Joe-Purvis/Power/Power.kicad_pcb

## KiCad design Power.kicad_pcb (2026-10-29)

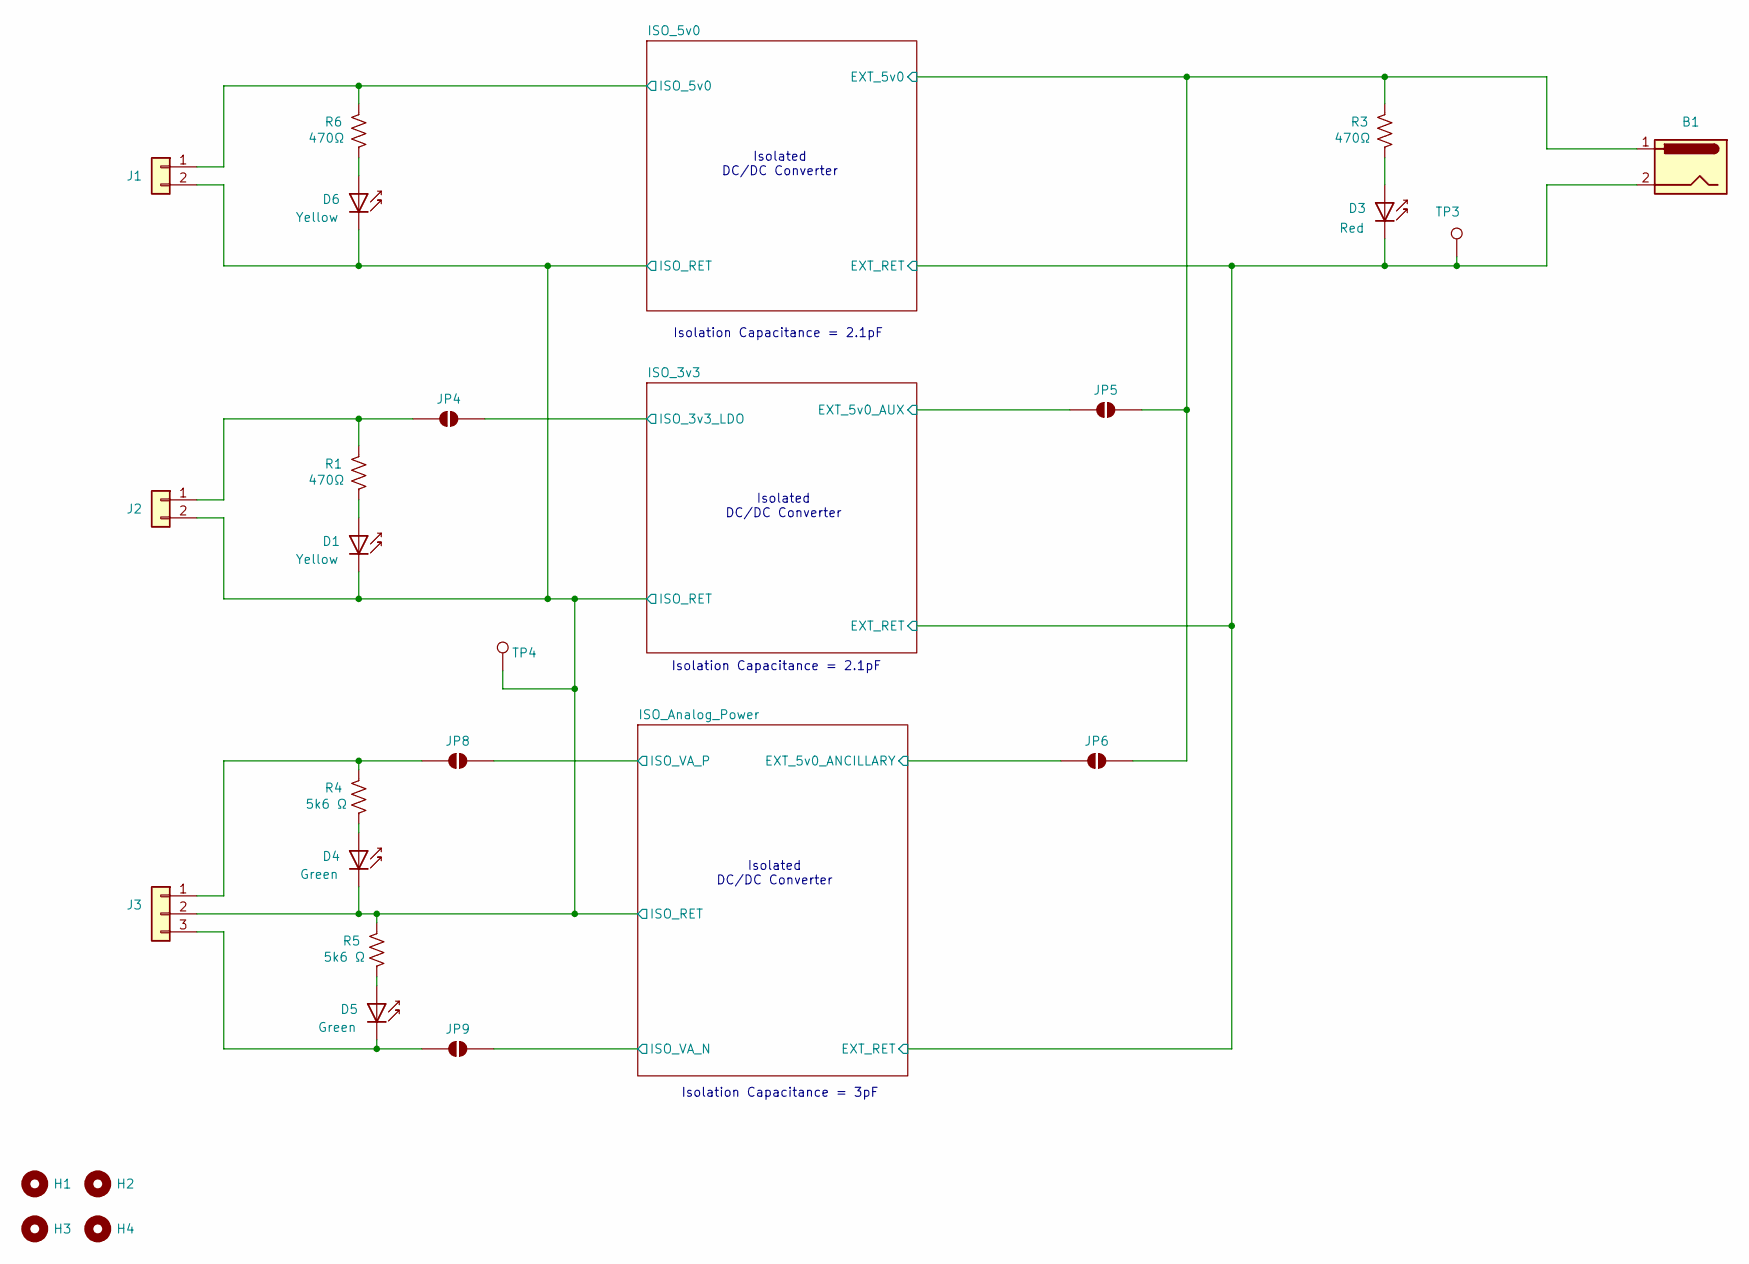
[picture p1: schematic Power.kicad_sch]

Parts:
B1: Barrel_Jack; BarrelJack_CUI_PJ-063AH_Horizontal
D1, D6: Yellow; LED_1206_3216Metric; LCSC C2298
D3: Red; LED_1206_3216Metric; LCSC C49018
D4, D5: Green; LED_1206_3216Metric; LCSC C14641
H1, H2, H3, H4: MountingHole; MountingHole_2.2mm_M2
J1, J2: Conn_01x02; PinHeader_1x02_P2.54mm_Vertical
J3: Conn_01x03; PinHeader_1x03_P2.54mm_Vertical
JP4, JP5, JP6, JP8, JP9: SolderJumper_2_Open; SolderJumper-2_P1.3mm_Open_RoundedPad1.0x1.5mm
R1, R3, R6: 470Ω; R_1206_3216Metric_Pad1.30x1.75mm_HandSolder; LCSC C4502
R4, R5: 5k6 Ω; R_1206_3216Metric_Pad1.30x1.75mm_HandSolder; Tolerance 5%; LCSC C2889795
TP3, TP4: TestPoint; TestPoint_Keystone_5000-5004_Miniature

Connections:
/ISO_3v3/EXT_5v0_AUX: JP5.1 (A); also elsewhere on the board
/ISO_3v3/EXT_RET: B1.2, D3.1 (K), TP3.1 (1_1); also elsewhere on the board
/ISO_3v3/ISO_3v3_LDO: JP4.2 (B); also elsewhere on the board
/ISO_5v0/EXT_5v0: B1.1, JP5.2 (B), JP6.2 (B), R3.2; also elsewhere on the board
/ISO_5v0/ISO_5v0: J1.1, R6.2; also elsewhere on the board
/ISO_Analog_Power/EXT_5v0_ANCILLARY: JP6.1 (A); also elsewhere on the board
/ISO_Analog_Power/ISO_RET: D1.1 (K), D4.1 (K), D6.1 (K), J1.2, J2.2, J3.2, R5.2, TP4.1 (1_1); also elsewhere on the board
/ISO_Analog_Power/ISO_VA_N: JP9.2 (B); also elsewhere on the board
/ISO_Analog_Power/ISO_VA_P: JP8.2 (B); also elsewhere on the board
unnamed: D1.2 (A), R1.1
unnamed: D3.2 (A), R3.1
unnamed: D4.2 (A), R4.1
unnamed: D5.2 (A), R5.1
unnamed: D5.1 (K), J3.3, JP9.1 (A)
unnamed: D6.2 (A), R6.1
unnamed: J2.1, JP4.1 (A), R1.2
unnamed: J3.1, JP8.1 (A), R4.2

Notes on the sheet:
Isolated DC/DC Converter
Isolation Capacitance = 2.1pF
Isolation Capacitance = 3pF

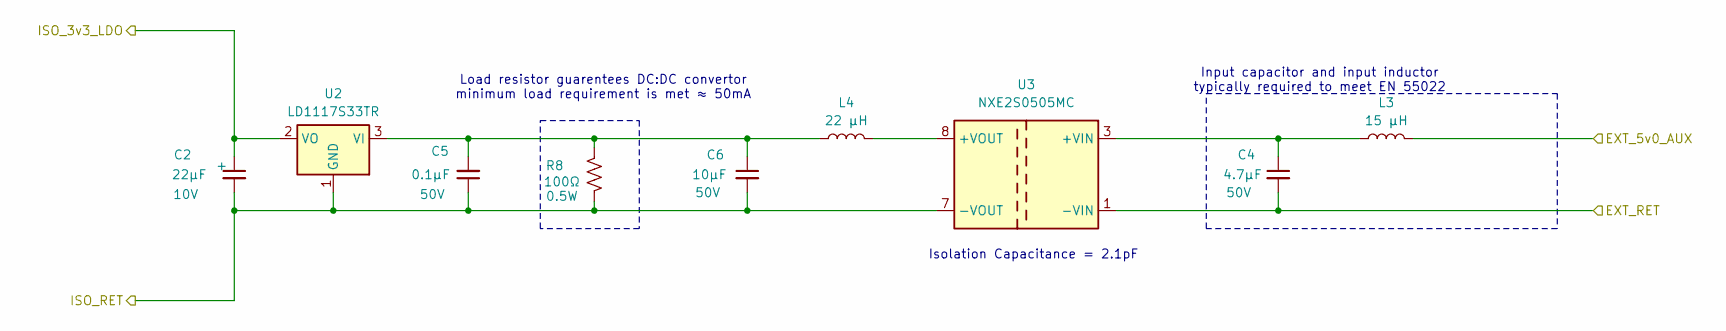
[picture p2: schematic ISO_3v3.kicad_sch]

Parts:
C2: 22µF; CP_EIA-3216-18_Kemet-A; Voltage Rating 10V; Tolerance 10%; LCSC C503893
C4: 4.7µF; C_1206_3216Metric; Voltage Rating 50V; LCSC C29823
C5: 0.1µF; C_1206_3216Metric_Pad1.33x1.80mm_HandSolder; Voltage Rating 50V; LCSC C24497
C6: 10µF; C_1206_3216Metric_Pad1.33x1.80mm_HandSolder; Voltage Rating 50V; LCSC C13585
L3: 15 µH; L_Changjiang_FNR4018S; Current Rating 1A; LCSC C167809
L4: 22 µH; L_Sunlord_SWPA5040; Current Rating 1.5A; LCSC C68434
R8: 100Ω; R_1206_3216Metric_Pad1.30x1.75mm_HandSolder; Voltage Rating 7.07V power-limited at 0.5W; series lim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; Tolerance 1%; LCSC C2978216
U2: LD1117S33TR; SOT-223-3_TabPin2; LCSC C86781
U3: NXE2S0505MC; Converter_DCDC_Murata_NXExSxxxxMC_SMD; LCSC C5817088

Connections:
/ISO_3v3/EXT_5v0_AUX: L3.2; also elsewhere on the board
/ISO_3v3/EXT_RET: C4.2, U3.1 (-VIN); also elsewhere on the board
/ISO_3v3/ISO_3v3_LDO: C2.1, U2.2 (VO); also elsewhere on the board
/ISO_Analog_Power/ISO_RET: C2.2, C5.1, C6.2, R8.1, U2.1 (GND), U3.7 (-VOUT); also elsewhere on the board
unnamed: C5.2, C6.1, L4.1, R8.2, U2.3 (VI)
unnamed: C4.1, L3.1, U3.3 (+VIN)
unnamed: L4.2, U3.8 (+VOUT)

Notes on the sheet:
Load resistor guarentees DC:DC convertor minimum load requirement is met ≈ 50mA
Input capacitor and input inductor typically required to meet EN 55022
Isolation Capacitance = 2.1pF

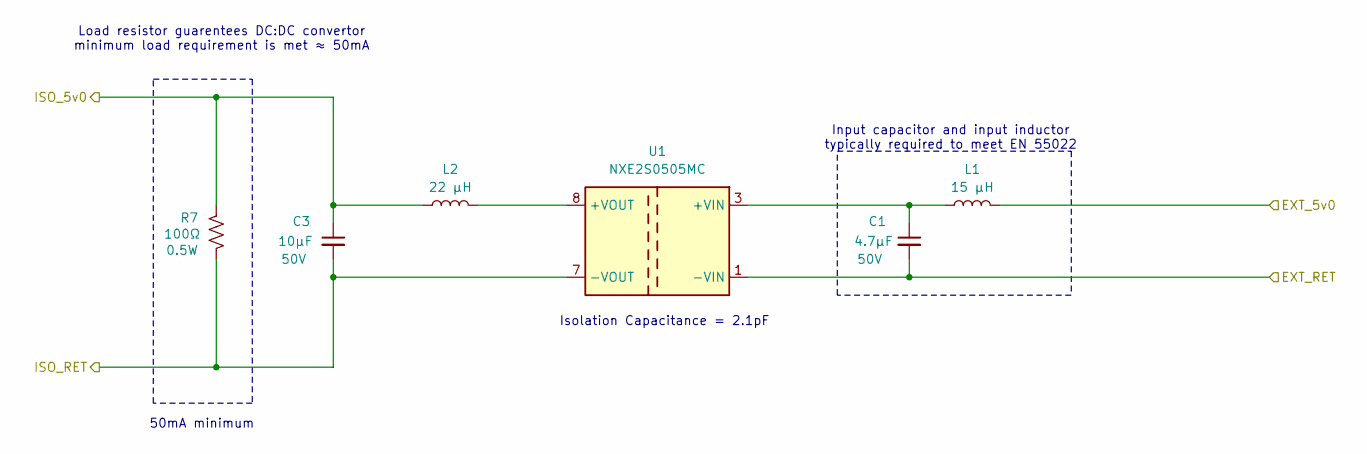
[picture p3: schematic ISO_5v0.kicad_sch]

Parts:
C1: 4.7µF; C_1206_3216Metric; Voltage Rating 50V; LCSC C29823
C3: 10µF; C_1206_3216Metric_Pad1.33x1.80mm_HandSolder; Voltage Rating 50V; LCSC C13585
L1: 15 µH; L_Changjiang_FNR4018S; Current Rating 1A; LCSC C167809
L2: 22 µH; L_Sunlord_SWPA5040; Current Rating 1.5A; LCSC C68434
R7: 100Ω; R_1206_3216Metric_Pad1.30x1.75mm_HandSolder; Voltage Rating 7.07V power-limited at 0.5W; series lim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; Tolerance 1%; LCSC C2978216
U1: NXE2S0505MC; Converter_DCDC_Murata_NXExSxxxxMC_SMD; LCSC C5817088

Connections:
/ISO_3v3/EXT_RET: C1.2, U1.1 (-VIN); also elsewhere on the board
/ISO_5v0/EXT_5v0: L1.2; also elsewhere on the board
/ISO_5v0/ISO_5v0: C3.1, L2.1, R7.2; also elsewhere on the board
/ISO_Analog_Power/ISO_RET: C3.2, R7.1, U1.7 (-VOUT); also elsewhere on the board
unnamed: C1.1, L1.1, U1.3 (+VIN)
unnamed: L2.2, U1.8 (+VOUT)

Notes on the sheet:
Load resistor guarentees DC:DC convertor minimum load requirement is met ≈ 50mA
Isolation Capacitance = 2.1pF
Input capacitor and input inductor typically required to meet EN 55022
50mA minimum

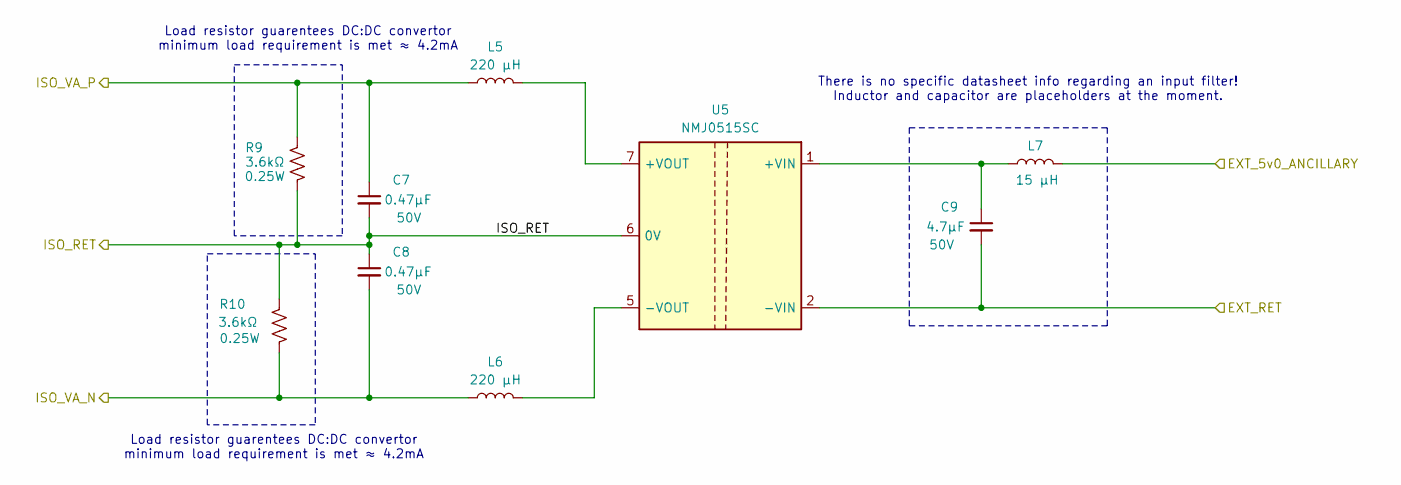
[picture p4: schematic ISO_Analog_Power.kicad_sch]

Parts:
C7, C8: 0.47µF; C_1206_3216Metric_Pad1.33x1.80mm_HandSolder; Voltage Rating 50V; LCSC C277483
C9: 4.7µF; C_1206_3216Metric; Voltage Rating 50V; LCSC C29823
L5, L6: 220 µH; L_Sunlord_SWPA4030; Current Rating 0.35A; LCSC C62495
L7: 15 µH; L_Changjiang_FNR4018S; Current Rating 1A; LCSC C167809
R9, R10: 3.6kΩ; R_1206_3216Metric_Pad1.30x1.75mm_HandSolder; Voltage Rating 30V power-limited at 0.25W; series limi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; Tolerance 1%; LCSC C137291
U5: NMJ0515SC

Connections:
/ISO_3v3/EXT_RET: C9.2, U5.2 (-VIN); also elsewhere on the board
/ISO_Analog_Power/EXT_5v0_ANCILLARY: L7.2; also elsewhere on the board
/ISO_Analog_Power/ISO_RET: C7.2, C8.1, R9.1, R10.2, U5.6 (0V); also elsewhere on the board
/ISO_Analog_Power/ISO_VA_N: C8.2, L6.1, R10.1; also elsewhere on the board
/ISO_Analog_Power/ISO_VA_P: C7.1, L5.1, R9.2; also elsewhere on the board
unnamed: C9.1, L7.1, U5.1 (+VIN)
unnamed: L5.2, U5.7 (+VOUT)
unnamed: L6.2, U5.5 (-VOUT)

Notes on the sheet:
Load resistor guarentees DC:DC convertor minimum load requirement is met ≈ 4.2mA
There is no specific datasheet info regarding an input filter! Inductor and capacitor are placeholders at the moment.

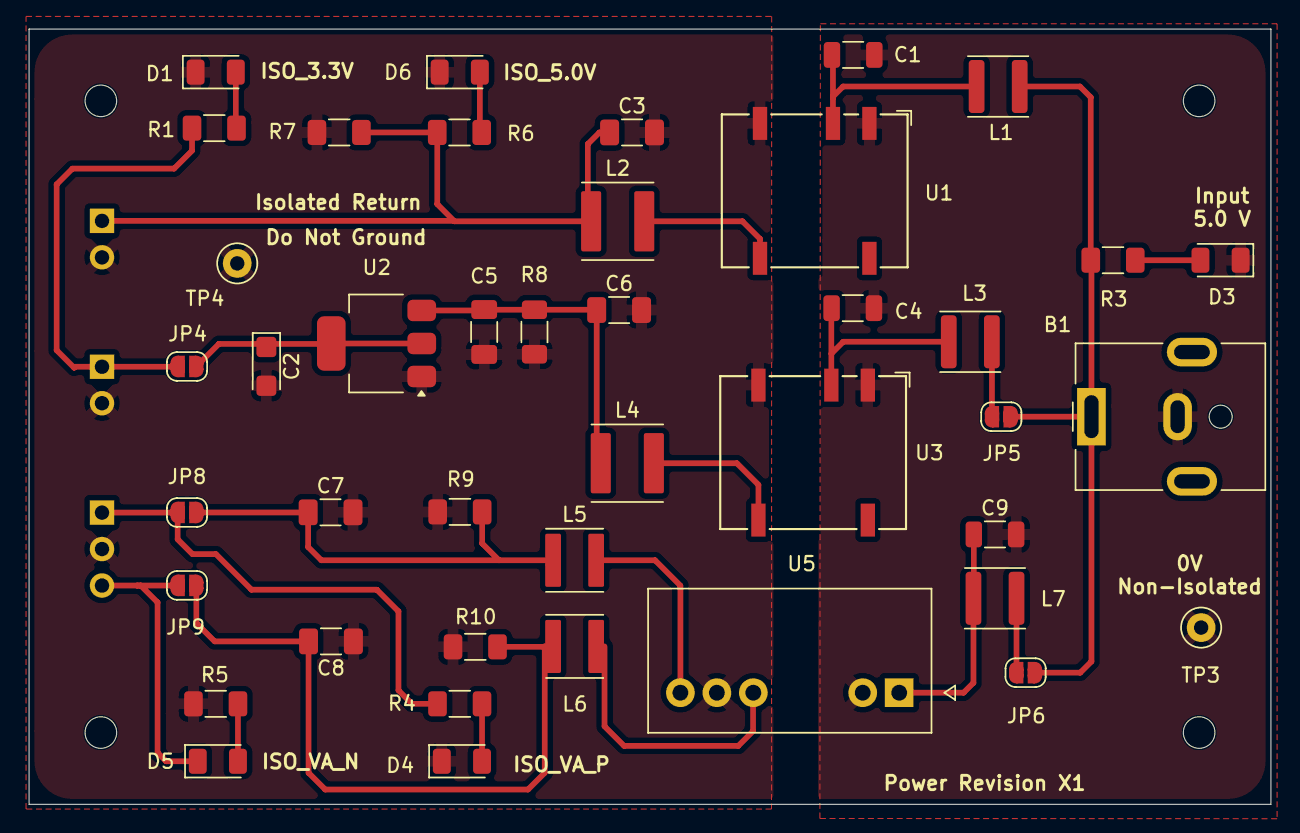
[picture p5: board Power.kicad_pcb from above]

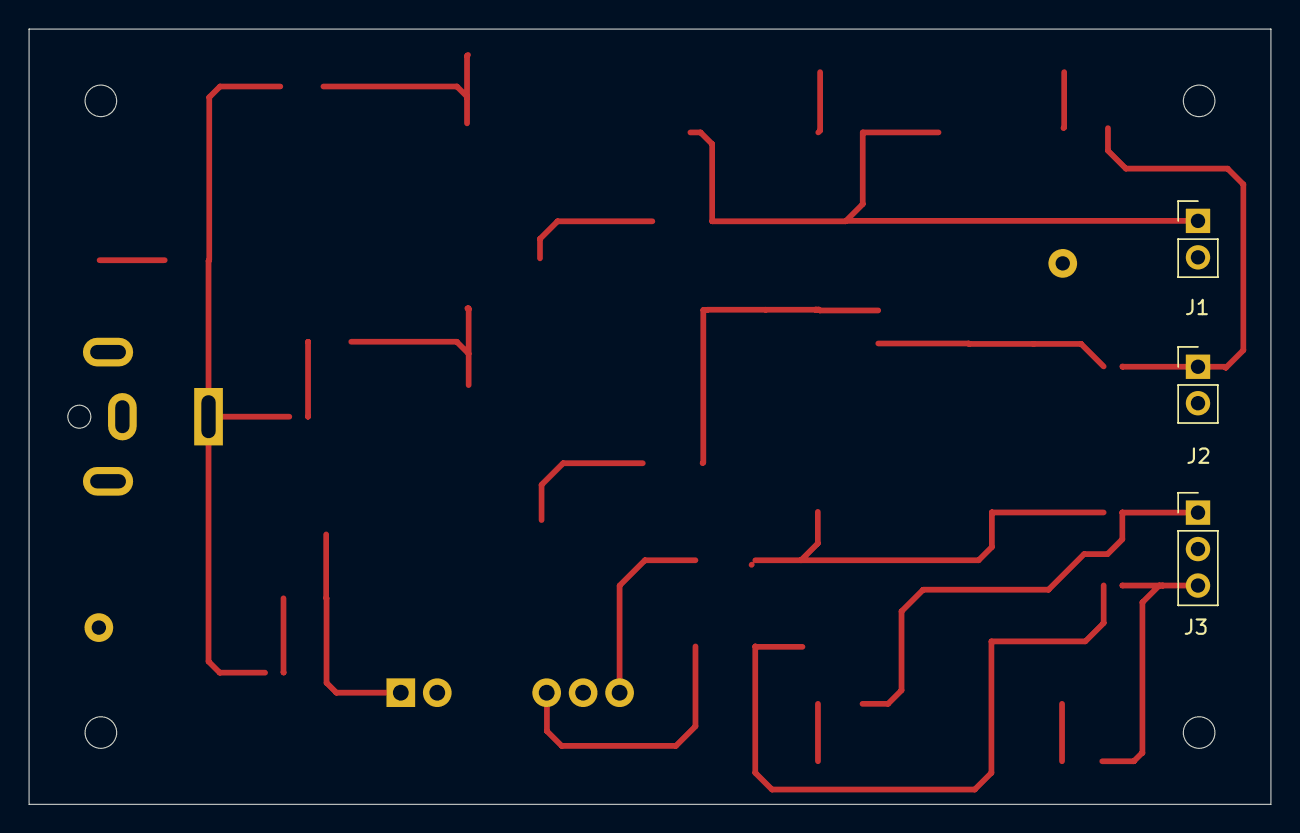
[picture p6: board Power.kicad_pcb from below]

Board: 2 copper layers, 86.5 x 54.0 mm, 50 parts (3 on the bottom side), 25 nets.

Other parts of the board:
QR1: LogicPower_Repo_QR; LogicPower_QR_Code
