Joe-Purvis/Power/(commit log)

2026-10-29 Rename project from LogicPower to Power
2026-10-29 Update Power design - 29 October 2026, DRC clean
    [ISO_3v3.kicad_sch, ISO_5v0.kicad_sch, ISO_Analog_Power.kicad_sch, Power.kicad_pcb, Power.kicad_sch]
